leshow/open_BEC/production/bom.csv

Designator | Footprint | Quantity | Value | LCSC Part #
C1, C2 | 1206 | 2 | 4.7uF 50V | C51205
C3, C4 | 0402 | 2 | 100nF 50V | C307331
C5, C6 | 0805 | 2 | 22uF 25V | C45783
L1 | L_Changjiang_FTC303018D | 1 | 4.7uH | C5832388
R1 | 0402 | 1 | 13.7k | C25854
R2 | 0402 | 1 | 15k | C25756
R3 | 0402 | 1 | 100k | C25741
U1 | TSOT-23-6 | 1 | LMR51430YFDDCR | C5219261
