leshow/open_BEC/micro_bec.kicad_pcb

## KiCad design micro_bec.kicad_pcb (2026-11-06)

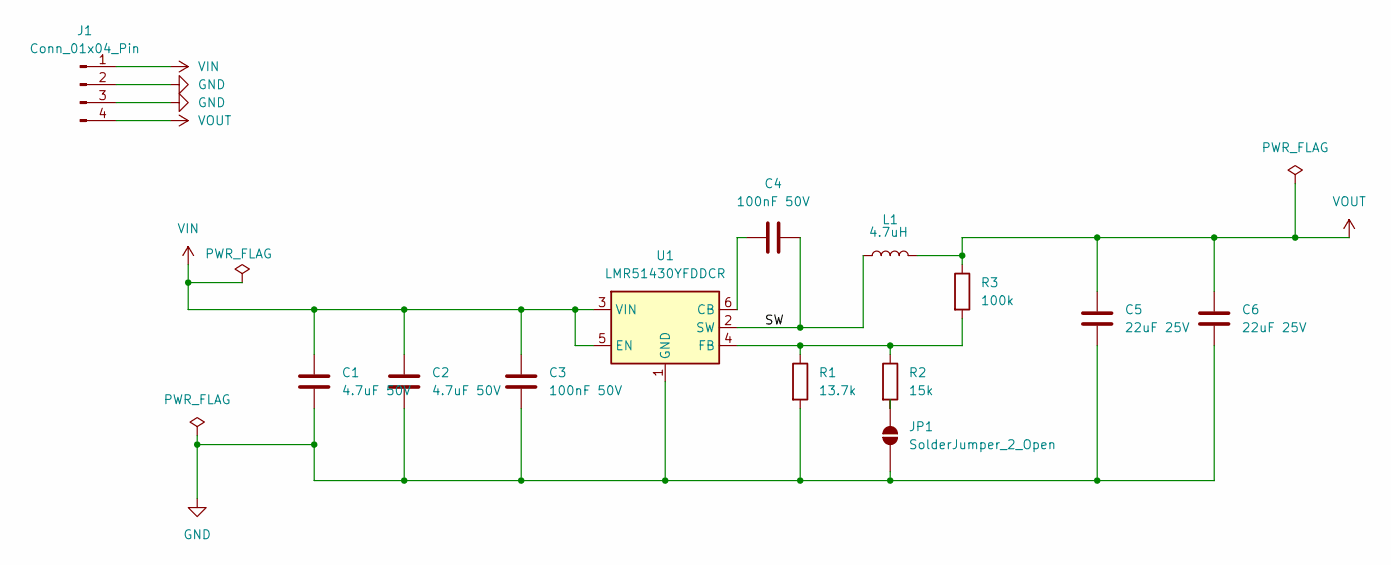
[picture p1: schematic micro_bec.kicad_sch]

Parts:
C1, C2: 4.7uF 50V; C_1206_3216Metric; LCSC C51205
C3, C4: 100nF 50V; C_0402_1005Metric; LCSC C307331
C5, C6: 22uF 25V; C_0805_2012Metric; LCSC C45783
J1: Conn_01x04_Pin; PinHeader_1x04_P2.54mm_Vertical
JP1: SolderJumper_2_Open; SolderJumper-2_P1.3mm_Open_Pad1.0x1.5mm
L1: 4.7uH; L_Changjiang_FTC303018D; LCSC C5832388
R1: 13.7k; R_0402_1005Metric; LCSC C25854
R2: 15k; R_0402_1005Metric; LCSC C25756
R3: 100k; R_0402_1005Metric; LCSC C25741
U1: LMR51430YFDDCR; TSOT-23-6; LCSC C5219261

Connections:
/SW: C4.1, L1.1, U1.2 (SW)
GND: C1.2, C2.2, C3.2, C5.2, C6.2, J1.2, J1.3, JP1.2 (B), R1.2, U1.1 (GND)
unnamed: JP1.1 (A), R2.2
unnamed: C4.2, U1.6 (CB)
unnamed: R1.1, R2.1, R3.2, U1.4 (FB)
VIN: C1.1, C2.1, C3.1, J1.1, U1.3 (VIN), U1.5 (EN)
VOUT: C5.1, C6.1, J1.4, L1.2, R3.1

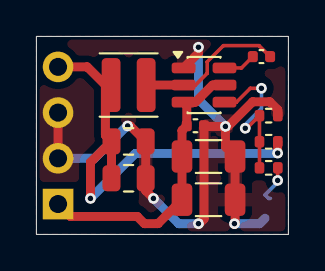
[picture p2: board micro_bec.kicad_pcb from above]

Board: 2 copper layers, 14.0 x 11.0 mm, 13 parts (1 on the bottom side), 7 nets.
