leshow/open_BEC/(commit log)

2026-11-03 produce gerbers for jlcpcb
    [bom.csv, designators.csv, micro_bec.kicad_pcb, micro_bec.kicad_sch, positions.csv]
2026-11-06 update inductor part so it renders/finds one on jlcpcb
    [bom.csv, micro_bec.kicad_pcb, micro_bec.kicad_sch, positions.csv]
